Derkades/woordklok/include/config.h

#ifndef CONFIG_H
#define CONFIG_H

#define FASTLED_INTERRUPT_RETRY_COUNT 1
#define FASTLED_ESP8266_RAW_PIN_ORDER
#define FASTLED_USE_GLOBAL_BRIGHTNESS 1
#define FASTLED_ALL_PINS_HARDWARE_SPI
#include <FastLED.h>
#include "effects.h"

// WiFi
#define WIFI_ENABLED
#ifdef WIFI_ENABLED
#define WIFI_HOSTNAME "woordklok"

// #define WIFI_AP_ENABLE
#ifdef WIFI_AP_ENABLE
    // Access point to configure WiFi
    #define WIFI_AP_SSID "Woordklok"
    #define WIFI_AP_PASS "klok7135"
    #define WIFI_AP_TITLE "Woordklok"
    #define WIFI_AP_TIMEOUT 10*60 // seconds before AP is shut down to try to connect to saved WiFi again

    #define WIFI_CONNECT_TIMEOUT 30 // seconds
#else
    // Hardcoded WiFi credentials
    #define WIFI_SSID ""
    #define WIFI_PASS ""
#endif

// MQTT
// #define MQTT_ENABLED
#ifdef MQTT_ENABLED
    #define MQTT_HOST IPAddress(10, 0, 1, 1)
    #define MQTT_PORT 1883
#endif

#endif // WIFI_ENABLED

// #define DCF77_ENABLED
#ifdef DCF77_ENABLED
    #define DCF77_DATA_PIN D1
#endif

// Initial state (or permanent state, if MQTT is not used)
#define INITIAL_EFFECT EFFECT_SHOWER_COLOR_FADE
#define INITIAL_HUE 192
#define INITIAL_SATURATION 192
#define INITIAL_BRIGHTNESS 255

// Time
#ifdef ESP8266
#include <TZ.h>
#define TIMEZONE TZ_Europe_Amsterdam
#else
#define TIMEZONE "CET-1CEST,M3.5.0,M10.5.0/3"
#endif
#define TIME_OFFSET 0 // Number of seconds, useful to make the clock run in advance so you arrive early

// LEDs
#define LED_CONFIG APA102, 13, 14, BGR

// LDR (automatic brightness)
//
// GND               LDR_PIN          3v3
//  |                   |              |
//  \-- 4.7k resistor --+-- LDR 5506 --/
#define LDR_ENABLED
#ifdef LDR_ENABLED
    // #define LDR_DEBUG // write LDR values to the log every second
    #define LDR_PIN 17 // 17 = esp8266 A0
    #define LDR_INPUT_MIN 50 // LDR value below which the clock displays minimum brightness
    #define LDR_INPUT_MAX 850 // LDR value above which the clock displays maximum brightness
    #define LDR_BRIGHTNESS_MIN 1
    #define LDR_BRIGHTNESS_MAX 255
#endif

// #define STARTUP_ANIMATION
#ifdef STARTUP_ANIMATION
// Startup animation
#define STARTUP_ANIMATION_DELAY 20
#define STARTUP_ANIMATION_COLOR_MOVING 0xFFFFFF
#define STARTUP_ANIMATION_COLOR_TRAIL 0x602000
#define STARTUP_ANIMATION_COLOR_BACKGROUND 0x200000
#endif

// Effects
#define RAINBOW_SATURATION 192
#define HUE_SHIFT_DEG 90
#define HUE_SHIFT (HUE_SHIFT_DEG / 360.0f) * 256.0f
#define BACKGROUND_DIM 4 // background brightness reduction factor (>=1)
#define RAIN_SPEED 6 // higher is faster

// #define EFFECT_VFLIP
#define EFFECT_ENABLE_BRIGHTNESS 6
#define EFFECT_DISABLE_BRIGHTNESS 2

// May cause LED flickering. Leave disabled when not needed.
#define DEBUG_SERIAL

#define BUTTON_PIN D1

#endif // CONFIG_H
