Derkades/woordklok/include/led.h

#ifndef LED_H
#define LED_H

#include "config.h"

#include <list>
#include <stdint.h>
#include <time.h>

#ifdef DCF77_ENABLED
#include <dcf77.h>
#endif

#include "effects.h"
#include "log.h"
#include "effects.h"

#define LETTER_LEDS 1 // number of leds per letter
#define NUM_ROWS 10
#define NUM_COLS 10
#define NUM_LETTERS NUM_ROWS*NUM_COLS
#define NUM_LEDS NUM_LETTERS*LETTER_LEDS

typedef uint16_t *word_t;

enum DisplayState {
    STATE_BOOT,
    STATE_BLANK,
    STATE_FADE_OUT,
    STATE_DISPLAY_TIME,
};

extern void led_setup();

extern void led_loop(struct tm *tm, bool on, uint8_t hue, uint8_t saturation, uint8_t brightness, LedEffect effect);

extern void startup_animation();

extern void status_led(uint32_t color);

#endif // LED_H
