Derkades/woordklok/src/effects.cpp

#include "effects.h"

const char *led_effect_names[] {
    "Vaste kleur",
    "Kleurtransitie",
    "Regenboog",
    "Schitter",
    "Regen",
    "Regen met kleurtransitie",
    "Testpatroon",
};

bool ledEffectFromString(const char *str, LedEffect *effect) {
    int i = 0;
    for (const char *led_effect_name : led_effect_names) {
        if (strcmp(str, led_effect_name) == 0) {
            *effect = static_cast<LedEffect>(i);
            return true;
        }
        i++;
    }
    return false;
}

const char *ledEffectToString(const LedEffect &ledEffect) {
    return led_effect_names[ledEffect];
}

LedEffect nextEffect(LedEffect &effect) {
    switch(effect) {
        case EFFECT_STATIC: return EFFECT_COLOR_FADE;
        case EFFECT_COLOR_FADE: return EFFECT_RAINBOW;
        case EFFECT_RAINBOW: return EFFECT_SPARKLE_STATIC;
        case EFFECT_SPARKLE_STATIC: return EFFECT_SHOWER;
        case EFFECT_SHOWER: return EFFECT_SHOWER_COLOR_FADE;
        case EFFECT_SHOWER_COLOR_FADE: return EFFECT_TEST_PATTERN;
        case EFFECT_TEST_PATTERN: return EFFECT_STATIC;
    }
}
