Derkades/woordklok/(commit log)

2023-01-13 Slightly reduce background led brightness
2023-01-14 Tweak shower effect, fix effect during boot
    [main.cpp]
2023-06-01 Fix time display for xx:58 and xx:59
    [main.cpp]
2025-09-10 Print version (WIP)
    [woordklok.scad]
2025-09-11 update led positions and other improvements
2025-09-12 print WIP
    [woordklok.scad]
2025-09-13 tweak led strip gap
    [woordklok.scad]
2025-09-13 print WIP change led direction, usb c
    [woordklok.scad]
2025-09-14 print: space for led solder, improve grid/letter positioning
    [woordklok.scad]
2025-09-14 inset back panel
    [woordklok.scad]
2025-09-14 add stl files to gitignore
2025-09-14 add small tolerance
    [woordklok.scad]
2025-09-14 fix ha_state_need_publish never being set to false
    [main.cpp]
2025-09-16 tweak nut trap position
    [woordklok.scad]
2025-09-17 fix light cover positioning
    [woordklok.scad]
2025-09-17 adjust power socket position
    [woordklok.scad]
2025-09-18 add holes for hanging string
    [woordklok.scad]
2025-09-20 fix invalid initial saturation
    [main.cpp]
2025-09-20 increase room for solder
    [woordklok.scad]
2025-09-20 configurable led pin
2025-09-20 print version config
2025-09-20 enable FastLED hardware SPI
2025-09-20 ldr wiring diagram
2025-09-22 fix nut and screw fit
    [woordklok.scad]
2025-09-22 improve sturdyness of back panel
    [woordklok.scad]
2025-09-22 fix typo in AP title
    [config.h]
2025-09-22 remove time filter so exception decoder works
2025-09-22 switch to older version of core and fastled to fix flickering
    [led.h]
2025-09-22 stronger back panel, screw mount
    [woordklok.scad]
2025-09-23 fix compatibilty with old SDK
    [main.cpp]
2025-09-27 update text
    [woordklok.scad]
2025-09-27 fix slot count
    [woordklok.scad]
2025-09-27 fix text centering
    [woordklok.scad]
2025-10-03 fix power socket cutout position
    [woordklok.scad]
2025-10-04 print improvements, english version
    [woordklok.scad]
2025-10-24 led adjustments
    [woordklok.scad]
2025-10-24 new letters pattern
    [woordklok.scad]
2025-10-24 fix slots
    [woordklok.scad]
2025-10-24 change led config
2025-11-10 fix feet nut trap
    [woordklok.scad]
2025-11-10 platformio config for esp8266 and esp32
2025-11-10 update foot screw head
    [foot.scad]
2025-11-10 new font
    [woordklok.scad]
2025-11-10 enable drawing of transparent layer
    [woordklok.scad]
2025-11-10 reduce height
    [foot.scad]
2025-11-11 feet nut tight fit
    [woordklok.scad]
2025-11-12 increase ldr hole size
    [woordklok.scad]
2025-11-12 fix 'twee' led position
    [led.cpp]
2025-11-24 angle back feet to compensate for sag
    [foot.scad]
2025-11-24 fix error blink led
    [led.cpp]
2025-11-24 hardware spi
2025-11-29 continue work on DCF77, add change effect button
2025-11-29 tweak LDR calibration
2026-01-03 foot flat head screw
    [foot.scad]
